dauzan/ShadeShift/foto/Electronic_Prototype.jpg

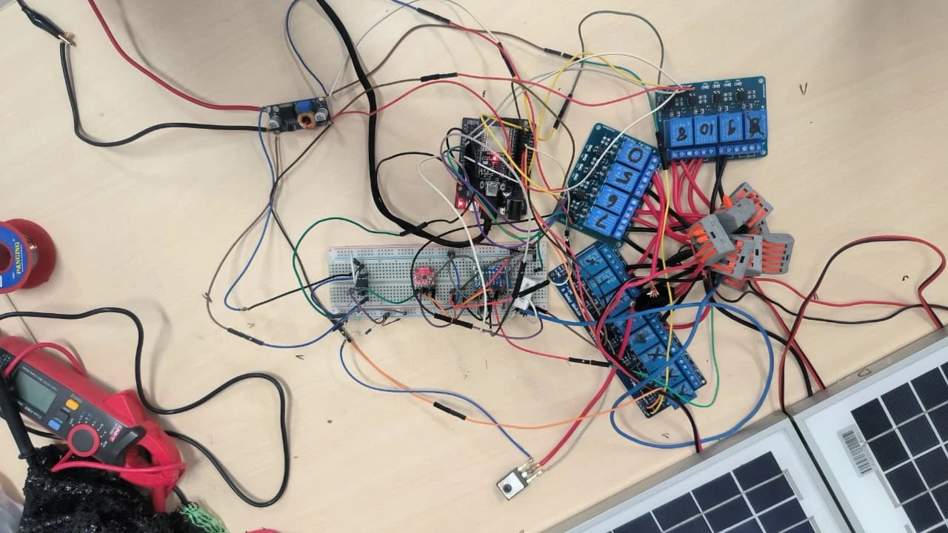
foto/Electronic_Prototype.jpg
