dauzan/ShadeShift/foto/Light_Module_Arrangement.jpg

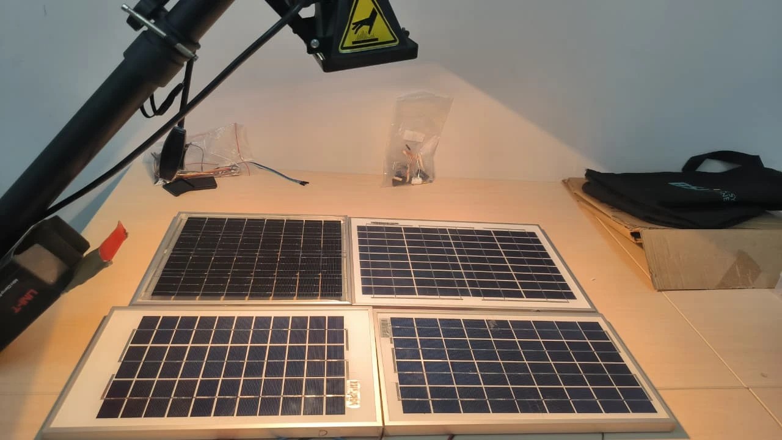
foto/Light_Module_Arrangement.jpg
