dauzan/ShadeShift/rangkaian/1_Relay_Matrix.png

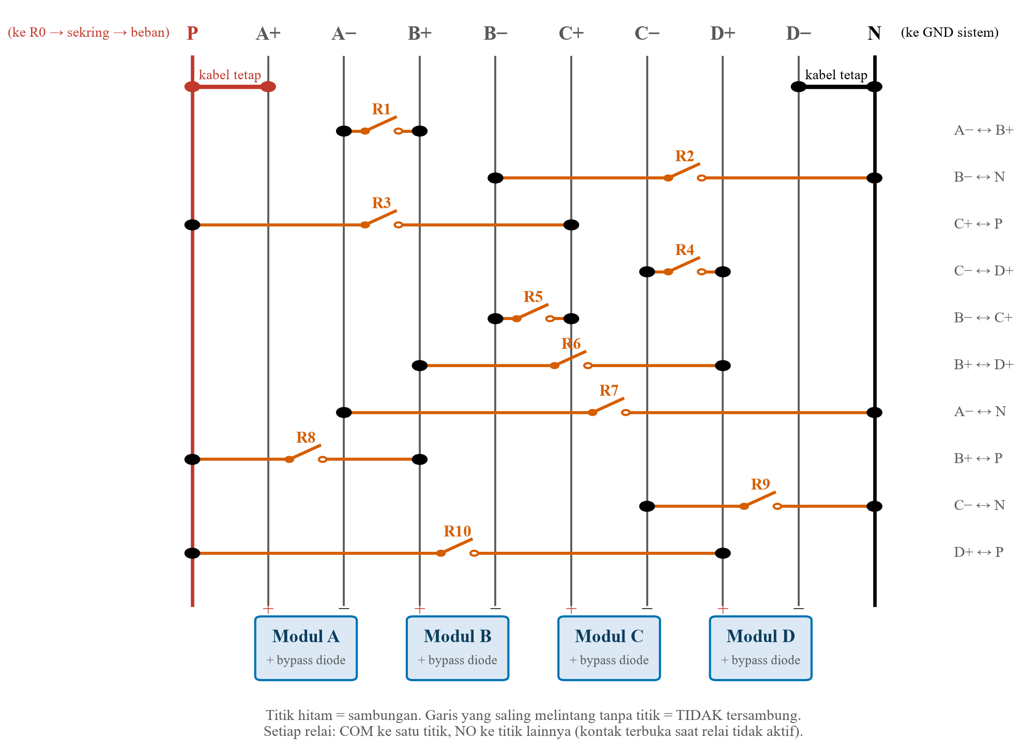
rangkaian/1_Relay_Matrix.png
