dauzan/ShadeShift/rangkaian/Block_Diagram.png

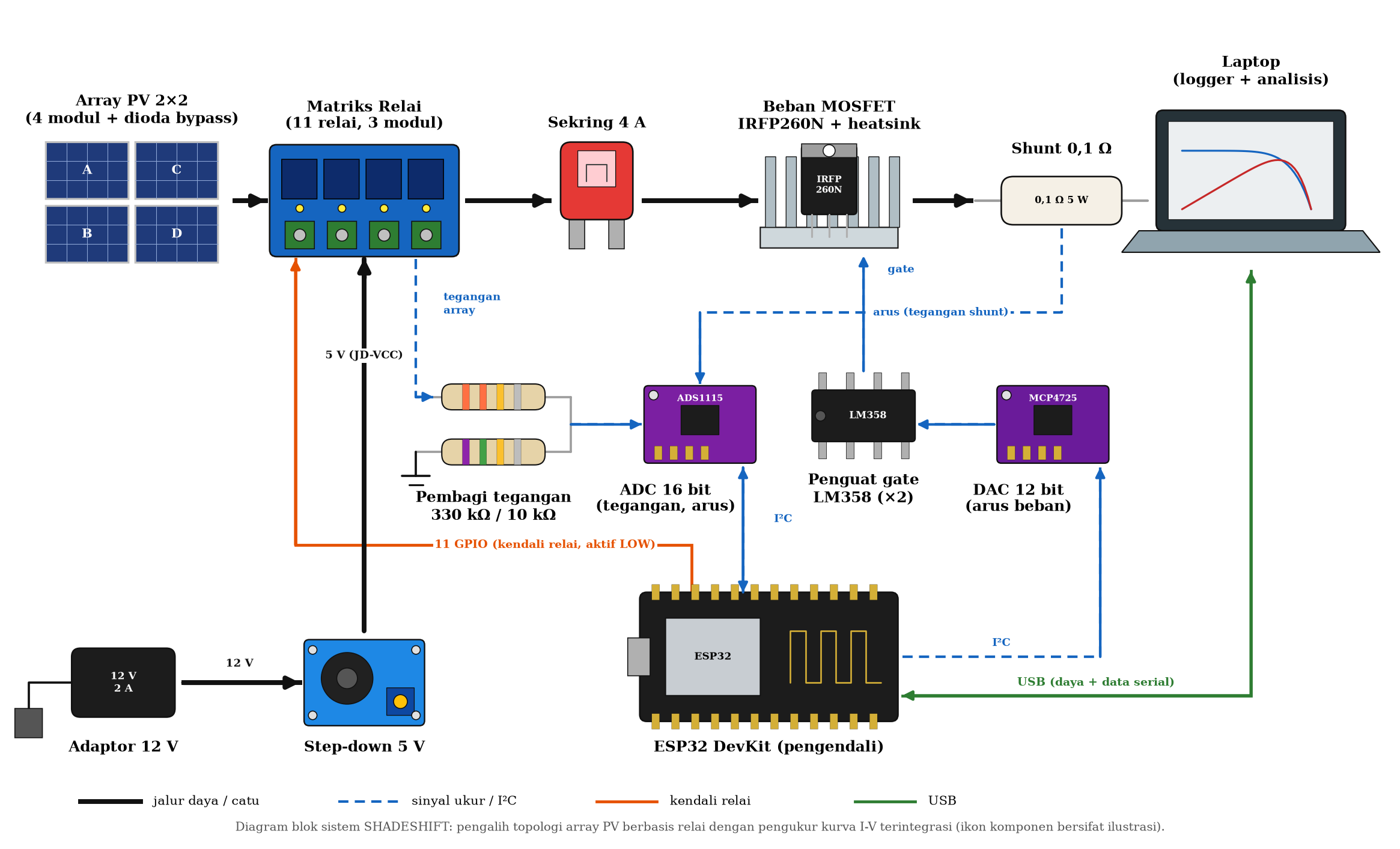
rangkaian/Block_Diagram.png
