dauzan/ShadeShift/rangkaian/L1_Panel_Diode_Wago.png

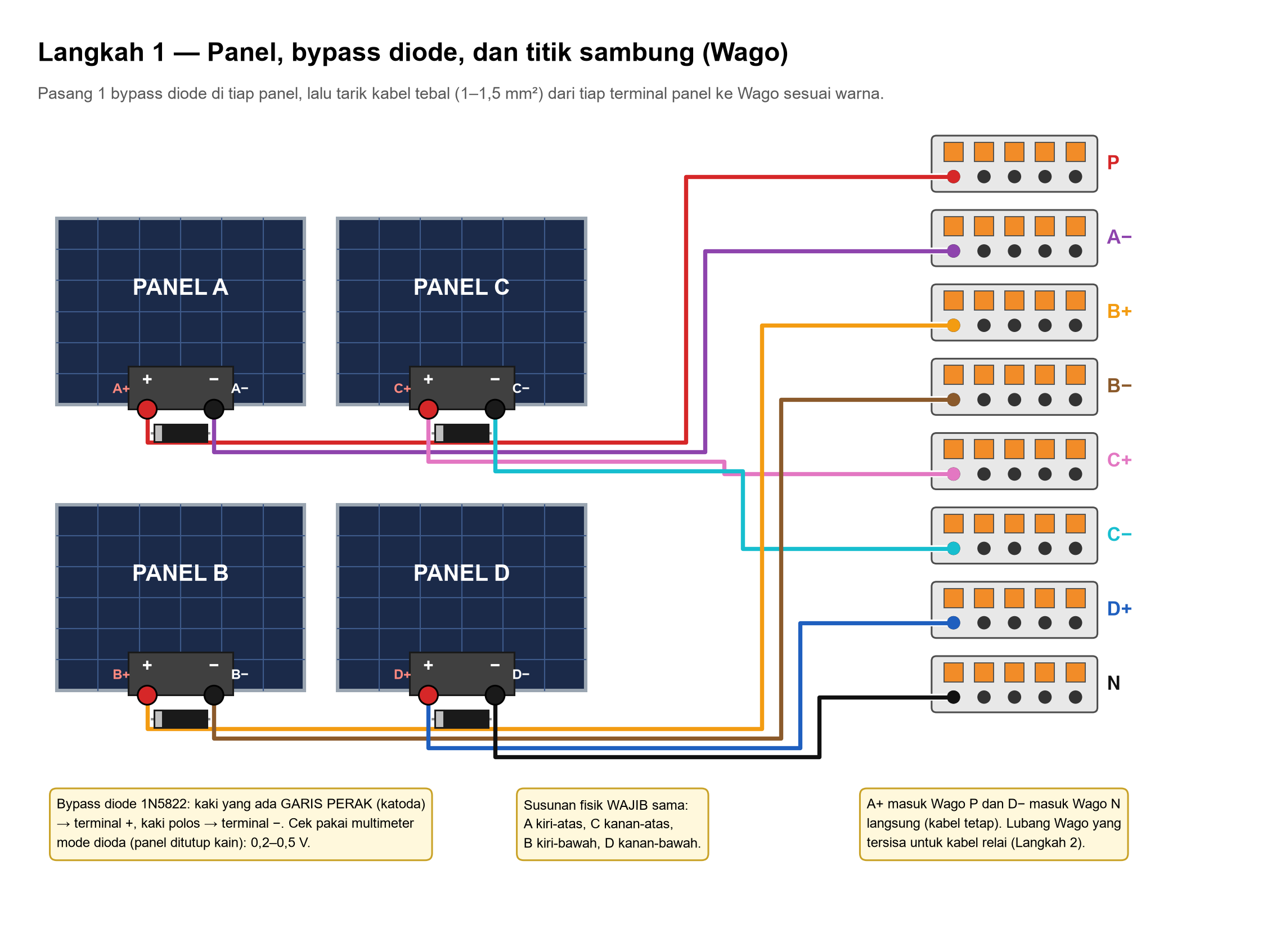
rangkaian/L1_Panel_Diode_Wago.png
