dauzan/ShadeShift/rangkaian/L2_Relay_to_Wago.png

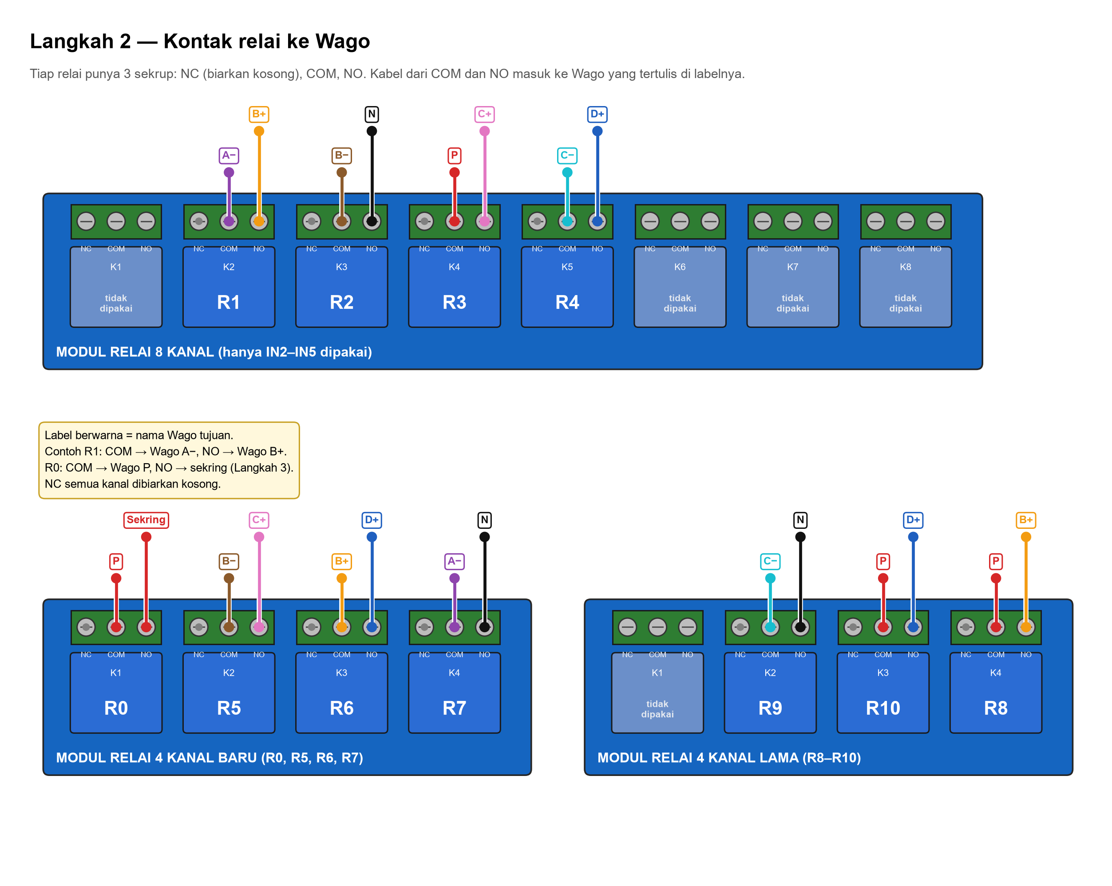
rangkaian/L2_Relay_to_Wago.png
