dauzan/ShadeShift/rangkaian/L3b_Gate_Operator.png

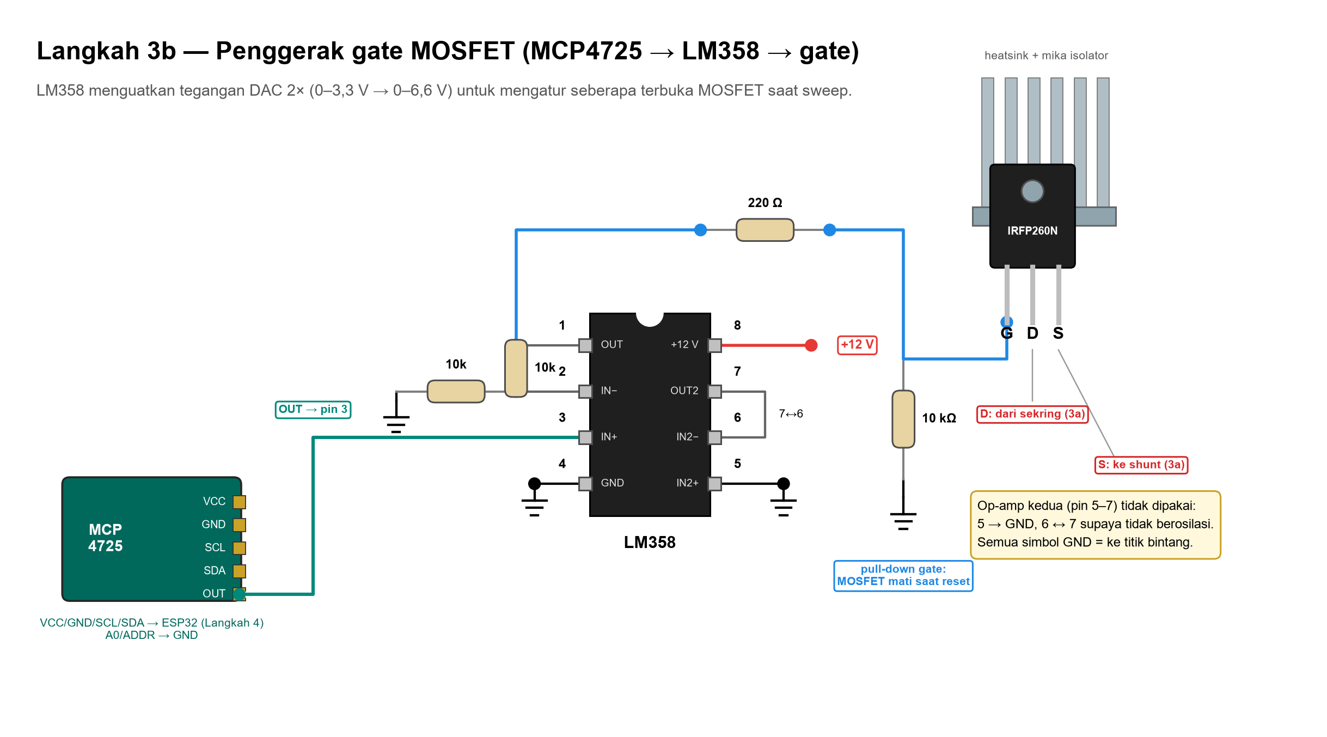
rangkaian/L3b_Gate_Operator.png
