dauzan/ShadeShift/rangkaian/L4a_ESP32_to_Relay.png

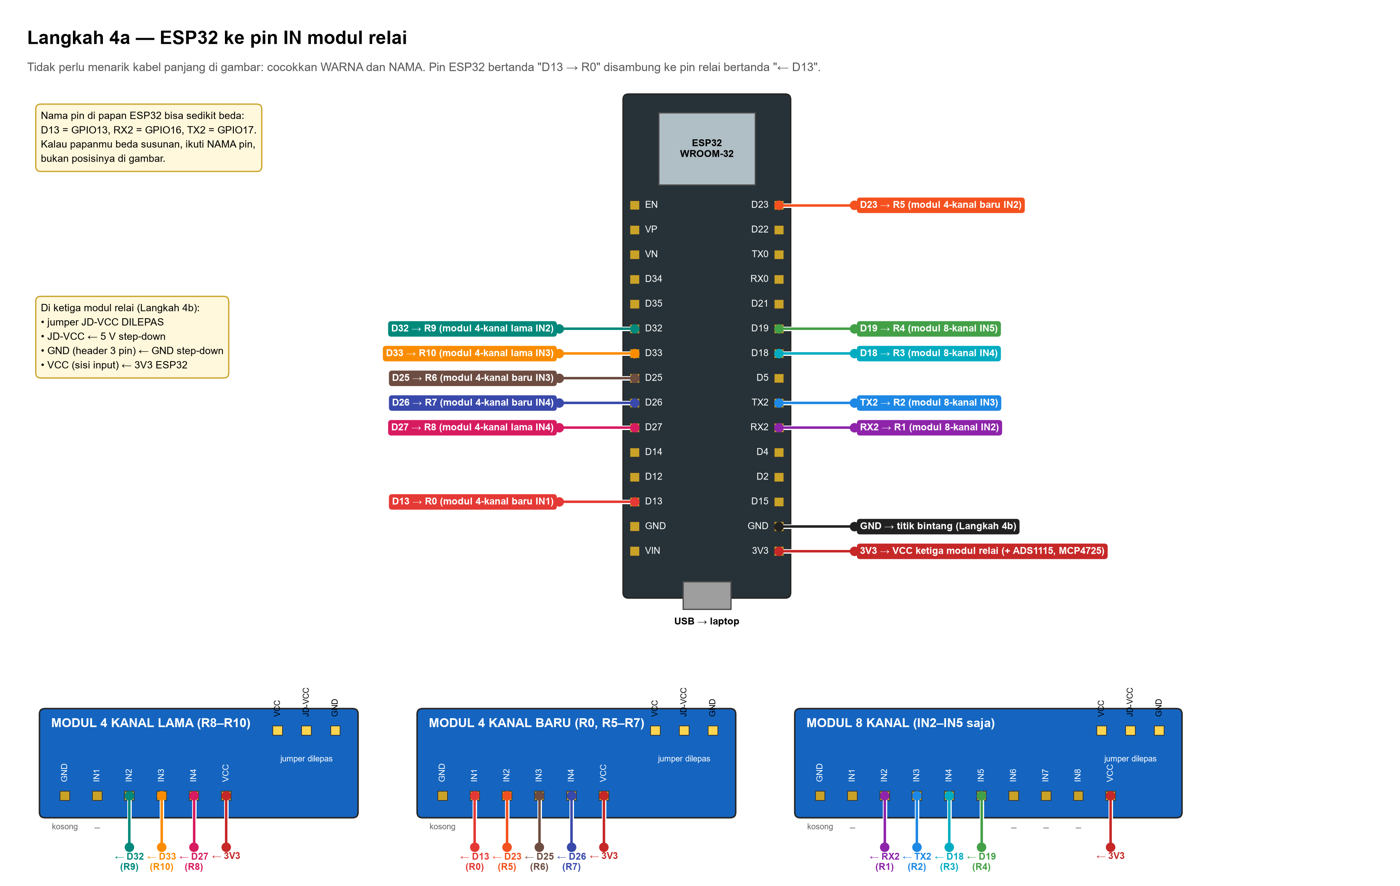
rangkaian/L4a_ESP32_to_Relay.png
