dauzan/ShadeShift/rangkaian/L4b_PowerSupply_I2C_Sensor.png

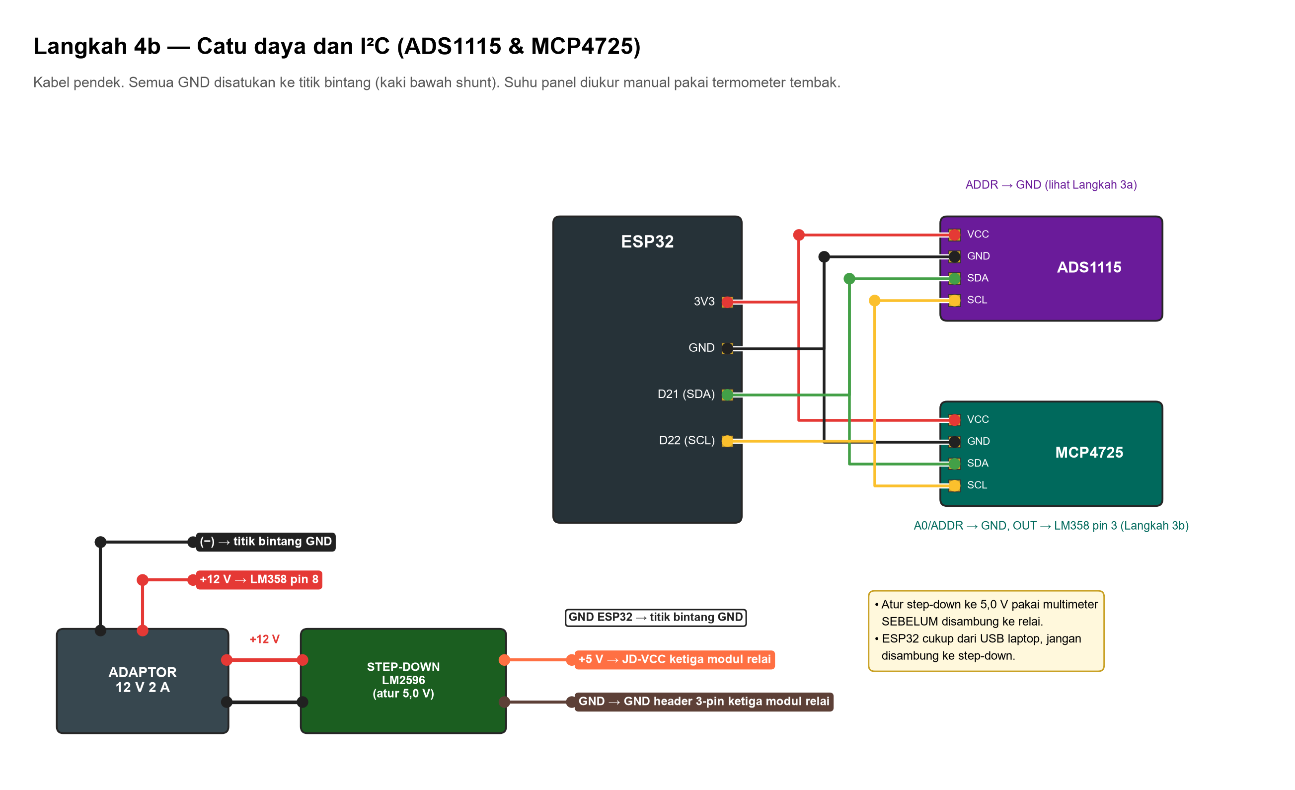
rangkaian/L4b_PowerSupply_I2C_Sensor.png
