dauzan/ShadeShift/rangkaian/L5_Ground_StarShape.png

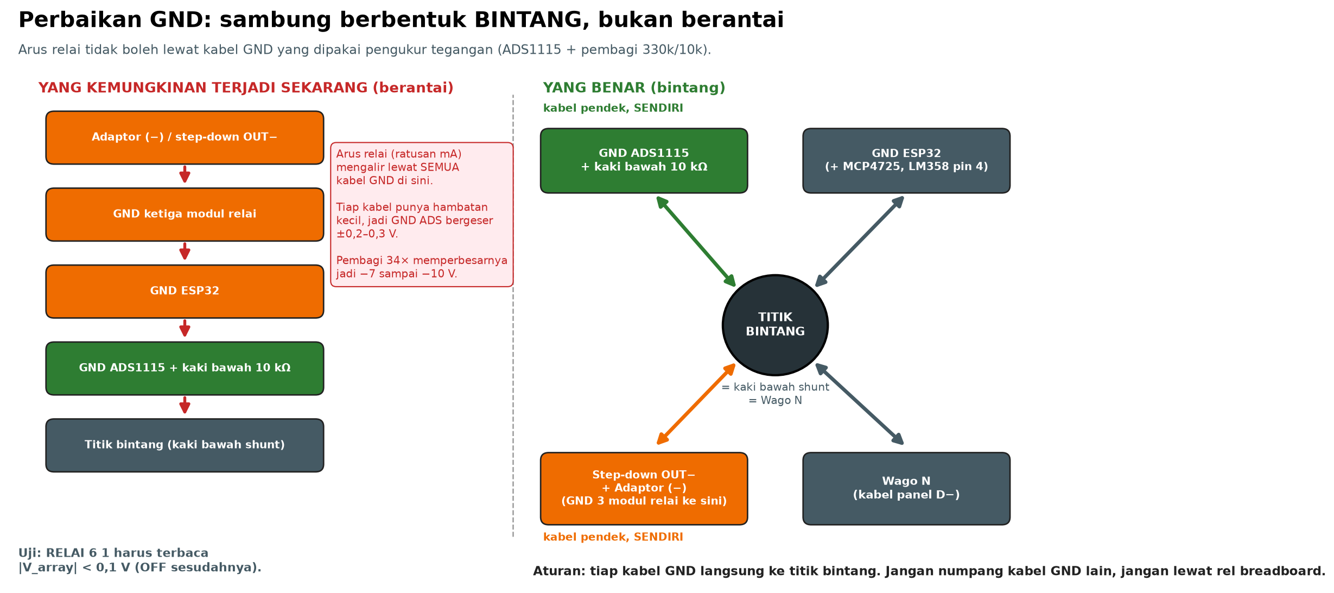
rangkaian/L5_Ground_StarShape.png
