dauzan/ShadeShift/rangkaian/ShadeShift_Scheme.png

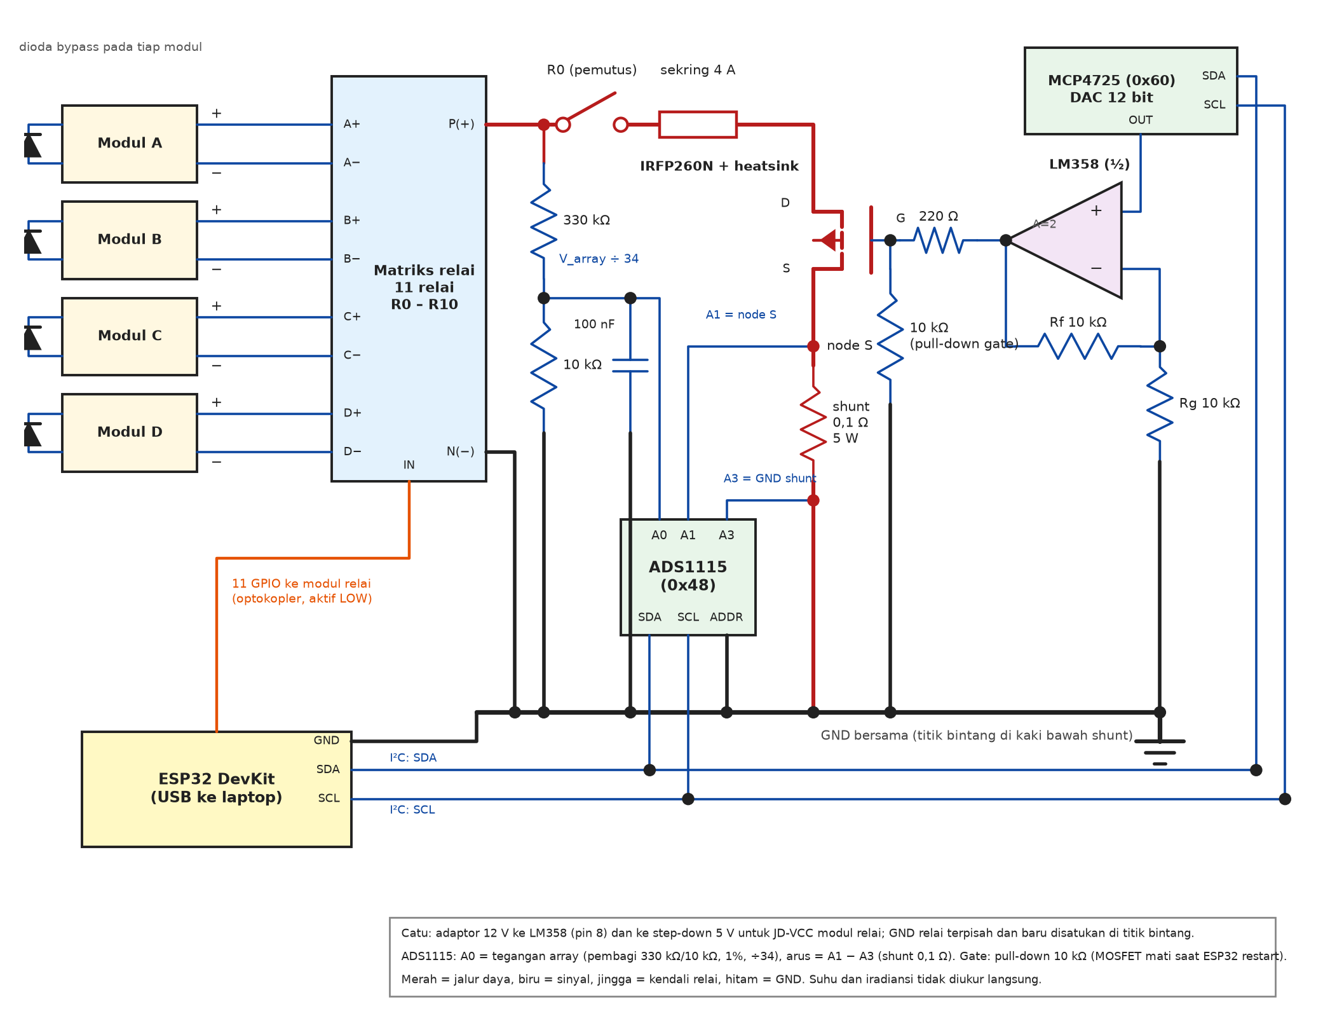
rangkaian/ShadeShift_Scheme.png
