dauzan/ShadeShift/SHADESHIFT_ML/edge_ai/kembaran_lab/kembaran_vs_lab.png

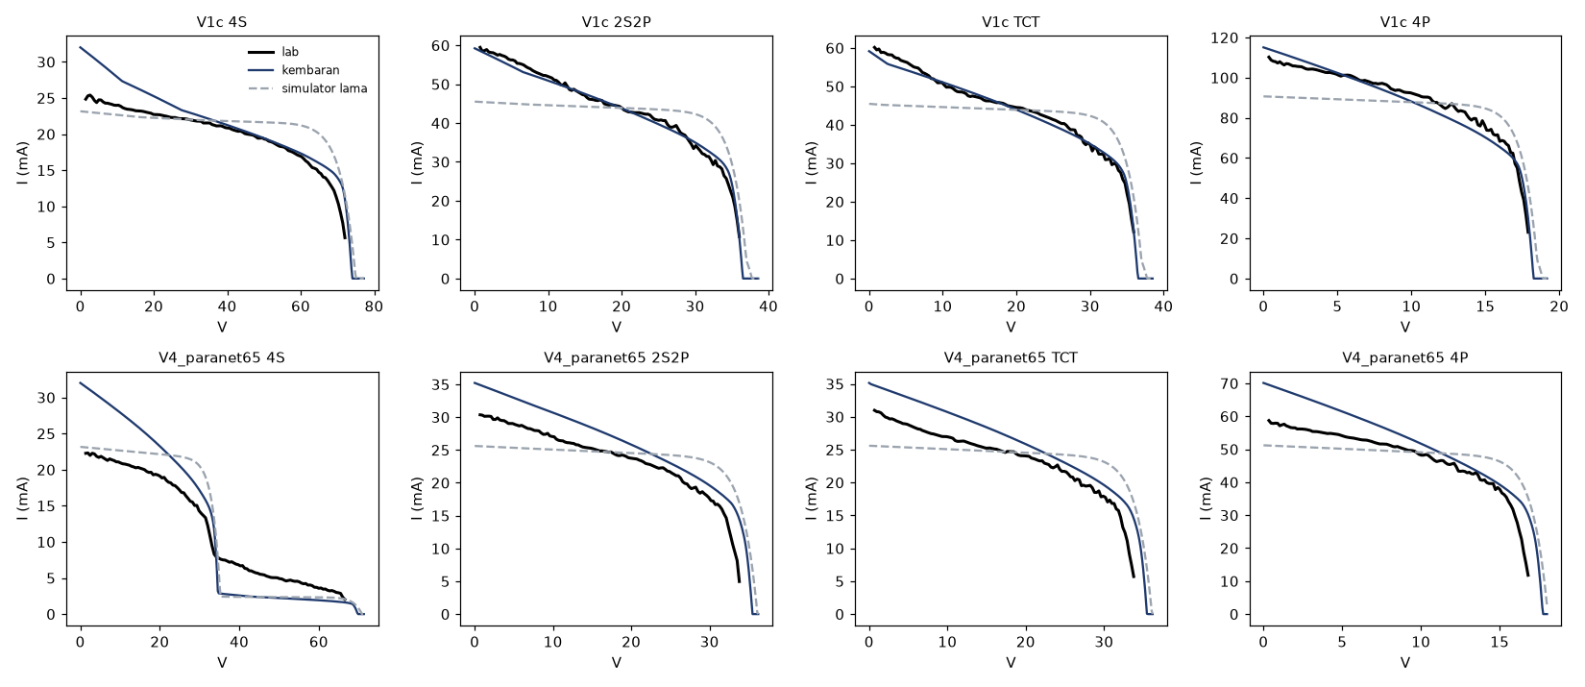
SHADESHIFT_ML/edge_ai/kembaran_lab/kembaran_vs_lab.png
