dauzan/ShadeShift/SHADESHIFT_ML/saklar/1_matriks_saklar_semikonduktor.png

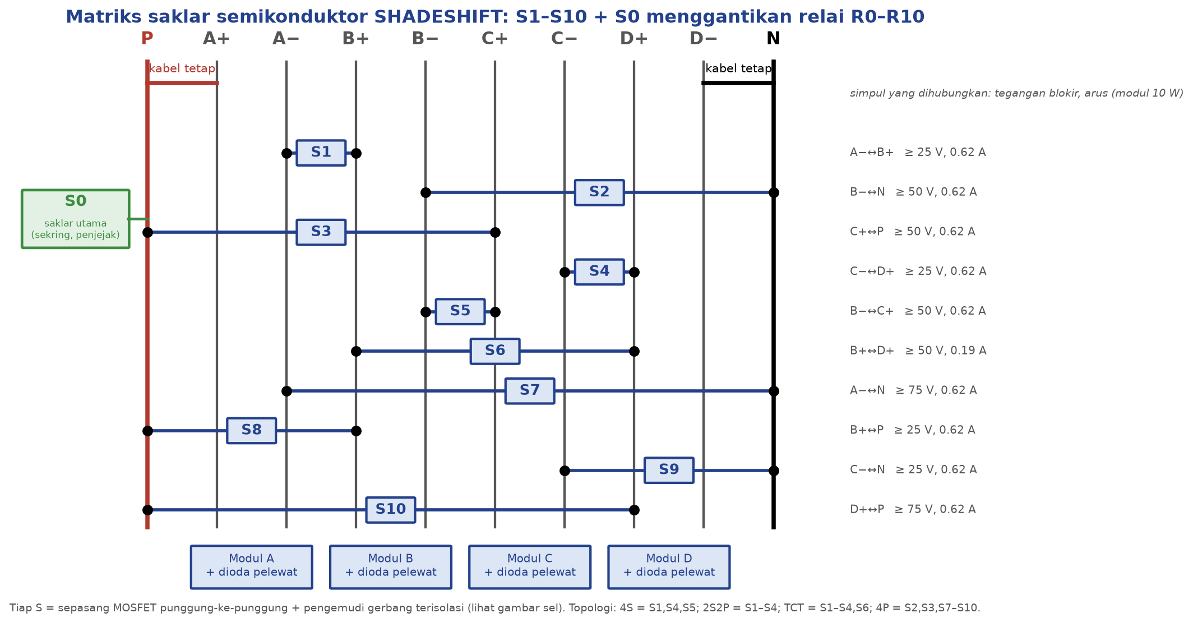
SHADESHIFT_ML/saklar/1_matriks_saklar_semikonduktor.png
