dauzan/ShadeShift/SHADESHIFT_ML/saklar/2_sel_saklar_semikonduktor.png

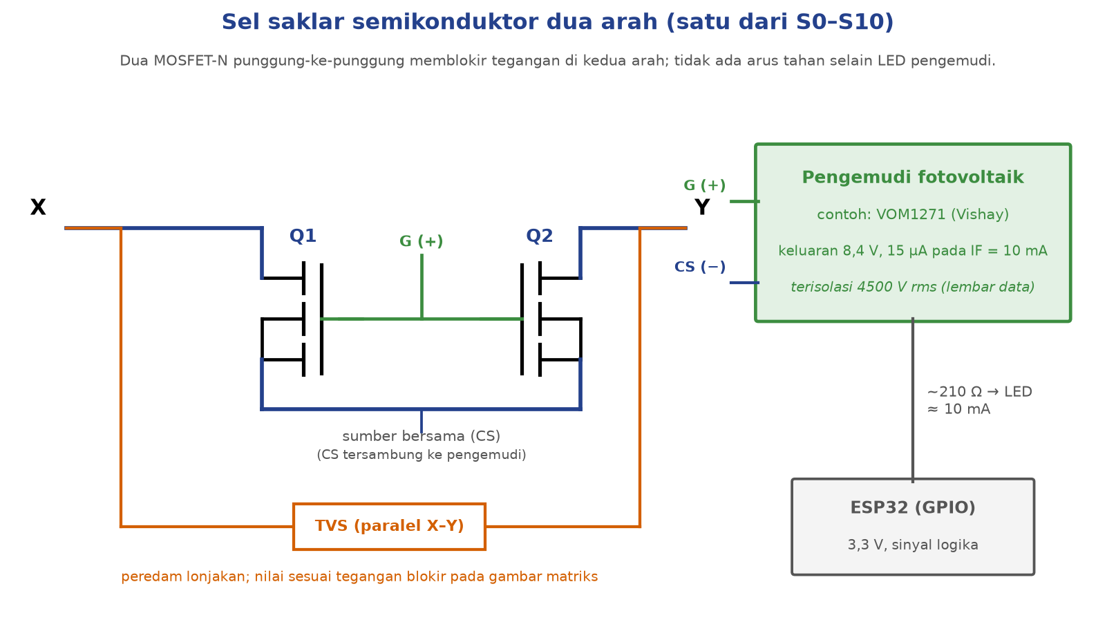
SHADESHIFT_ML/saklar/2_sel_saklar_semikonduktor.png
