dauzan/ShadeShift/SHADESHIFT_ML/saklar/3_perbandingan_relai_semikonduktor.png

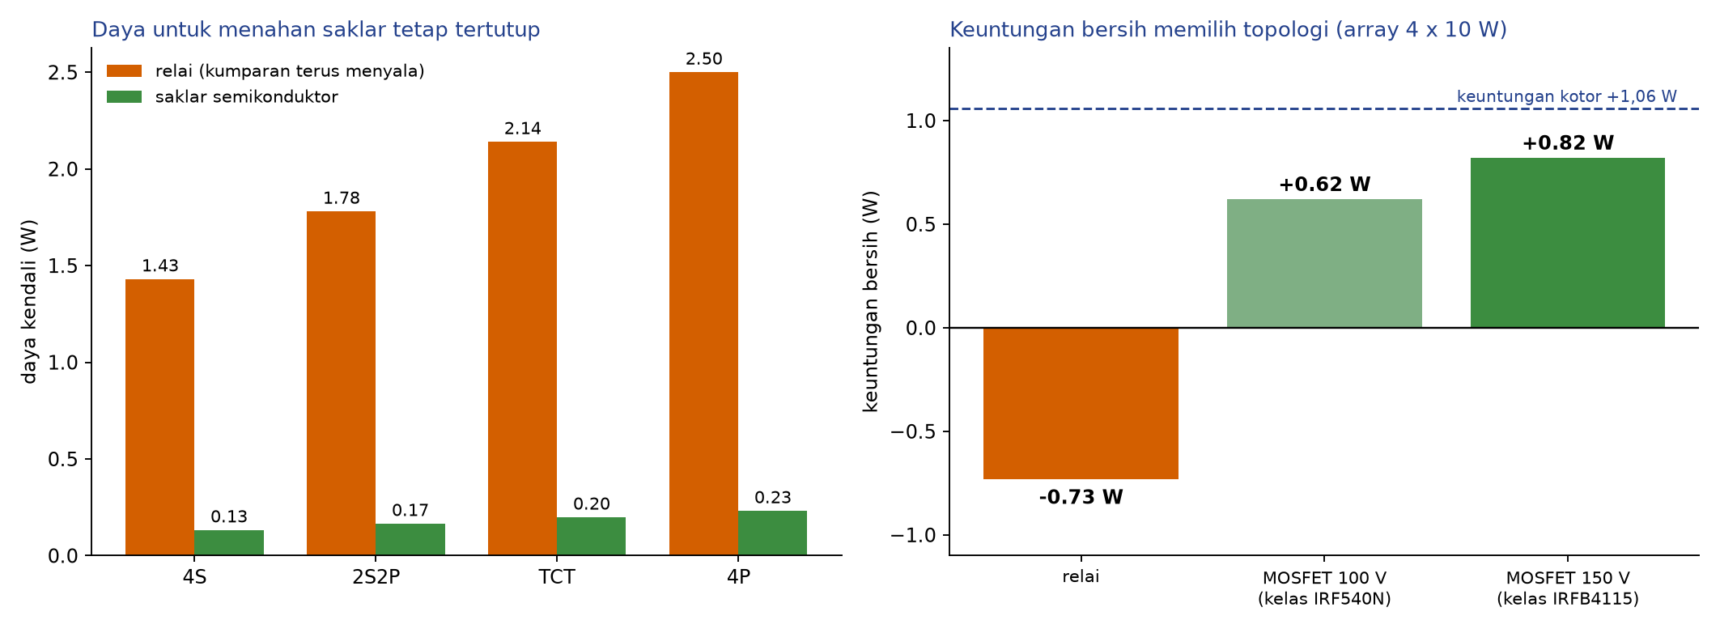
SHADESHIFT_ML/saklar/3_perbandingan_relai_semikonduktor.png
