dauzan/ShadeShift/SHADESHIFT_ML/uji_model/hasil/grafik_pemilihan_fisik.png

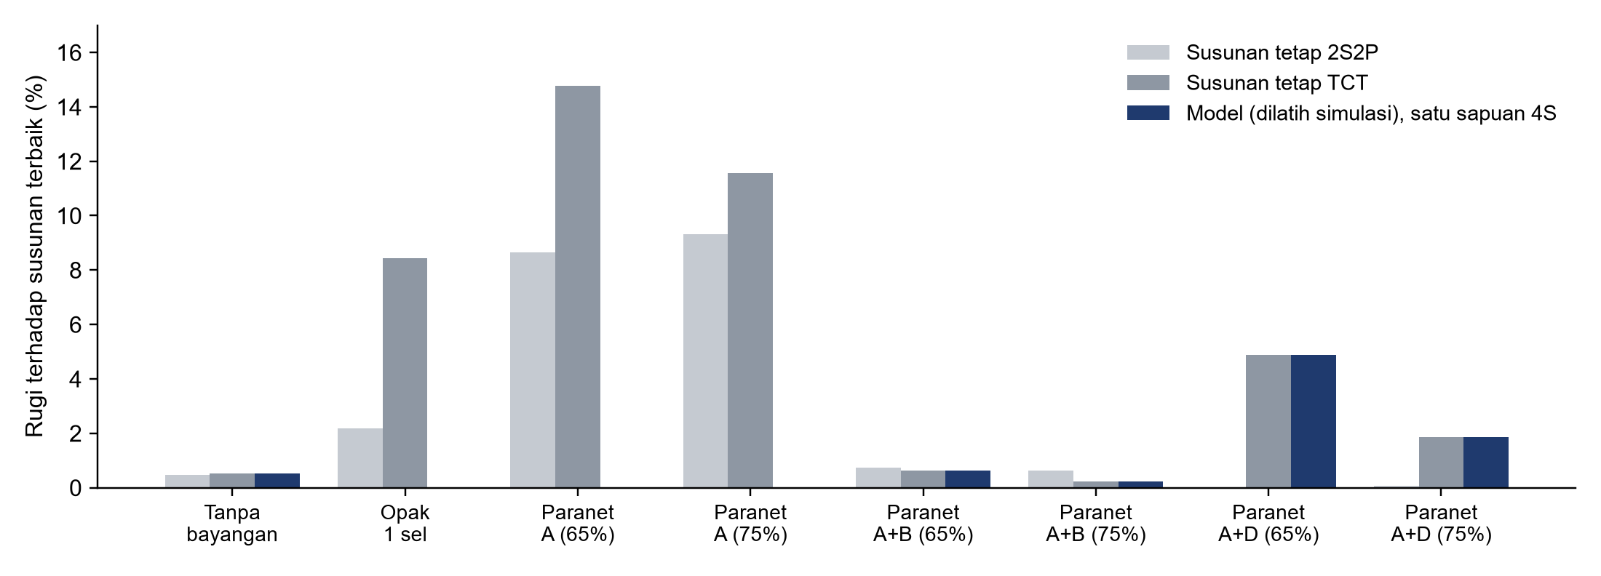
SHADESHIFT_ML/uji_model/hasil/grafik_pemilihan_fisik.png
