dauzan/ShadeShift/rangkaian/2_Measurement_Control_Circuit.png

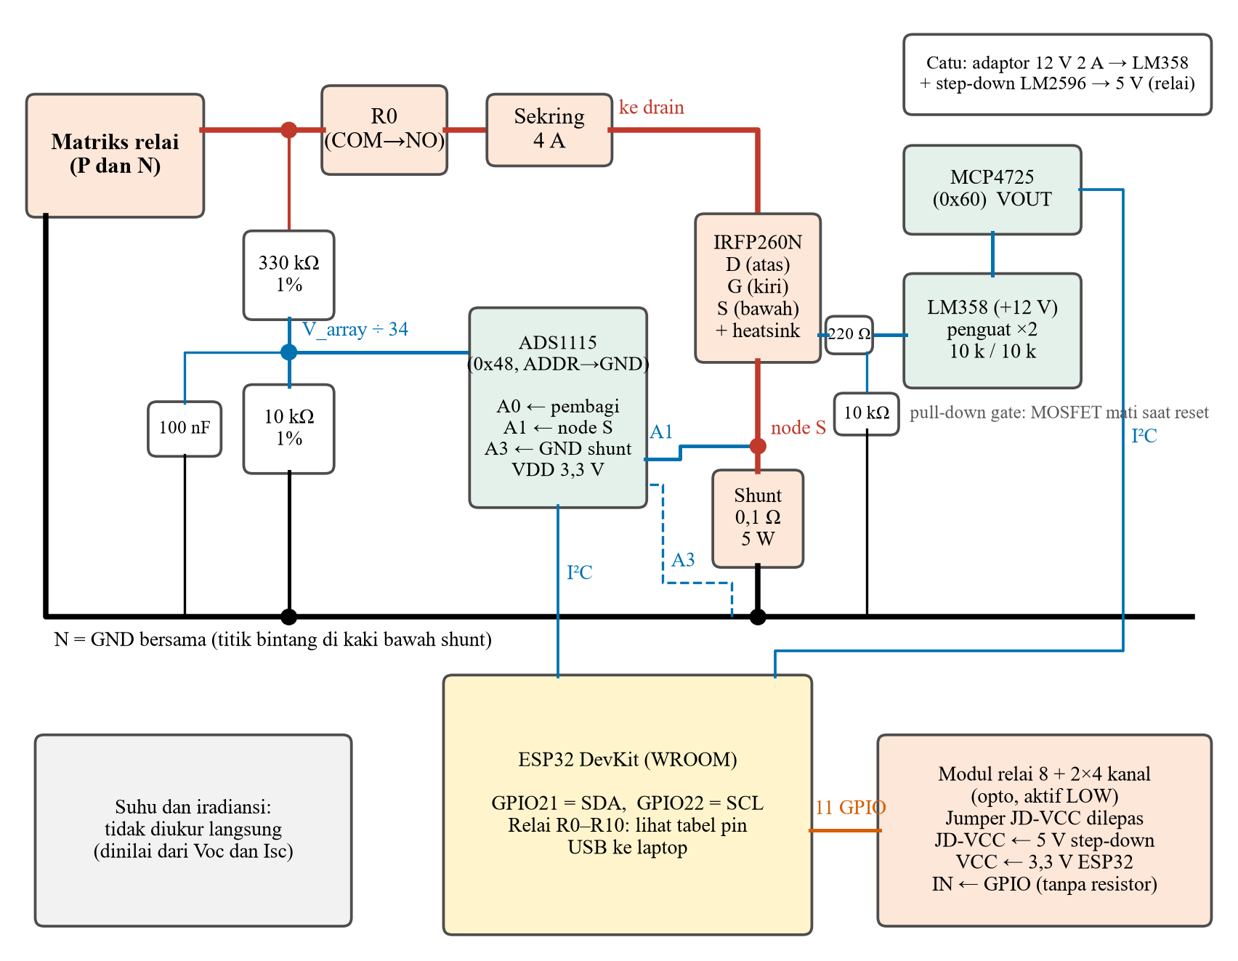
rangkaian/2_Measurement_Control_Circuit.png
