dauzan/ShadeShift/rangkaian/L3a_Measurement_Power_Path.png

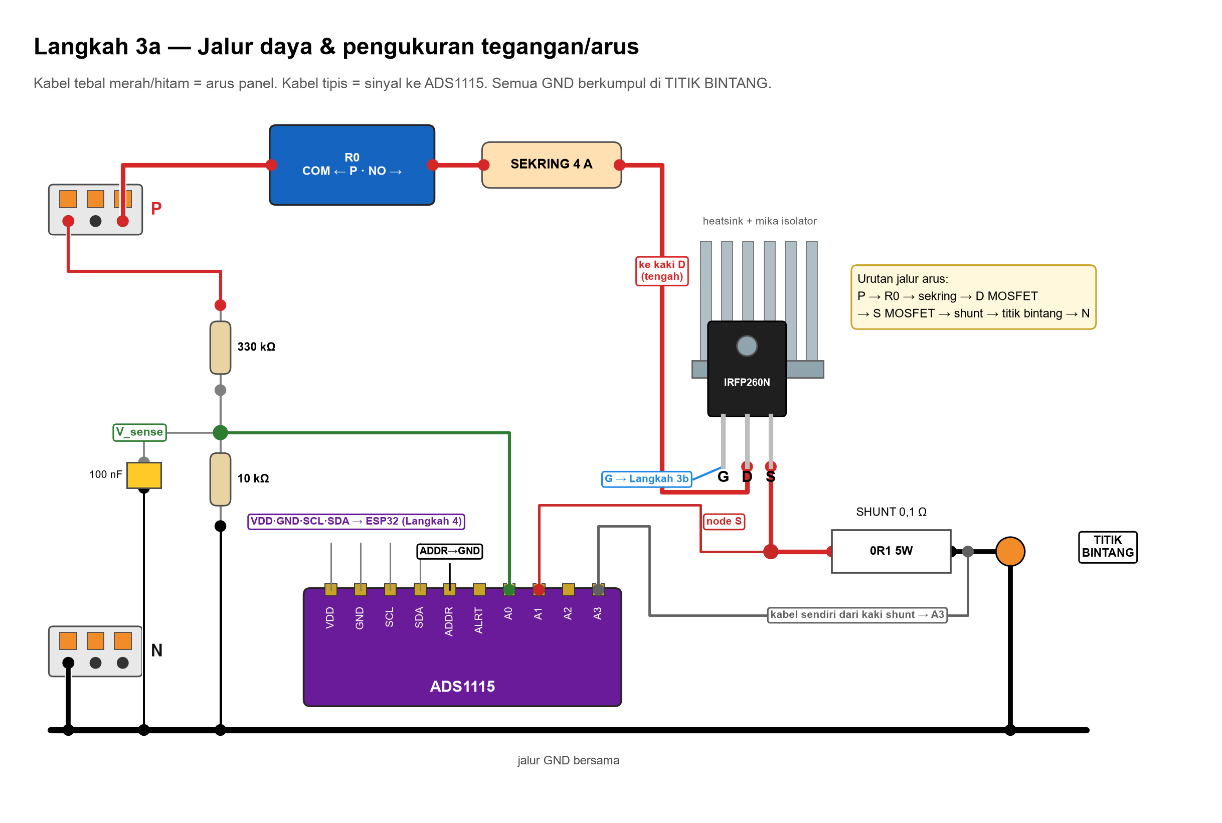
rangkaian/L3a_Measurement_Power_Path.png
