dauzan/ShadeShift/SHADESHIFT_ML/edge_ai/pemilih/uji_pemilih/data_uji.h

// Kurva uji (lab, sapuan 4S, mentah dari berkas CSV) + fitur dan keputusan harapan. Dibuat otomatis oleh latih_ekspor.py.
#pragma once
#define N_UJI 12
#define N_MAKS_TITIK 202
static const char* UJI_NAMA[N_UJI] = {"V1c_4S_u1", "V1_4S_u1", "V3_opak_4S_u1", "V3_paranet65_4S_u1", "V3_paranet75_4S_u2", "V4_paranet65_4S_u1", "V4_paranet75_4S_u3", "V6_paranet65_4S_u1", "V6_paranet75_4S_u2", "V1b_4S_u2", "V3_opak_4S_u3", "V6_paranet65_4S_u3"};
static const uint16_t UJI_N[N_UJI] = {202, 202, 202, 202, 202, 202, 202, 202, 202, 202, 202, 202};
static const float UJI_V[N_UJI][N_MAKS_TITIK] = {
  {73.552597f, 73.1636963f, 73.1467972f, 73.1340027f, 73.1340027f, 73.1128006f, 73.1212997f, 73.0958023f, 73.1128006f, 73.0596008f, 73.0979004f, 73.0341034f, 73.0765991f, 73.0085983f, 73.0596008f, 72.9746017f, 73.0383987f, 72.9533997f, 73.0129013f, 72.9279022f, 72.9980011f, 72.893898f, 72.9682007f, 72.8619995f, 72.9300003f, 72.8365021f, 72.9215012f, 72.7939987f, 72.9023972f, 72.7578964f, 72.8768997f, 72.7110977f, 72.8429031f, 72.6750031f, 72.8216019f, 72.6473999f, 72.7770004f, 72.6219025f, 72.7429962f, 72.5580978f, 72.6984024f, 72.5093002f, 72.6601028f, 72.4561005f, 72.6324997f, 72.411499f, 72.5751038f, 72.3583984f, 72.5475006f, 72.3095016f, 72.5028992f, 72.254303f, 72.4391022f, 72.1989975f, 72.3902969f, 72.1288986f, 72.332901f, 72.0672989f, 72.2669983f, 71.9865036f, 72.2309036f, 71.9121017f, 72.1565018f, 71.844101f, 72.088501f, 71.7548981f, 72.0077972f, 71.6570969f, 71.9248962f, 71.6018982f, 71.831398f, 71.4978027f, 71.7570038f, 71.3872986f, 71.6656036f, 71.2916031f, 71.5530014f, 71.1747971f, 71.4934998f, 71.0514984f, 71.3744965f, 70.9069977f, 71.2427979f, 70.7944031f, 71.1407013f, 70.6710968f, 70.9962997f, 70.5202026f, 70.8623962f, 70.3843002f, 70.6648026f, 70.1802979f, 70.4969025f, 69.9869003f, 70.3714981f, 69.7574005f, 70.1355972f, 69.5109024f, 69.7594986f, 69.1708984f, 69.385498f, 68.7331009f, 68.7990036f, 68.4377975f, 68.2125015f, 67.7152023f, 67.2753983f, 66.8651962f, 66.3339996f, 65.8919983f, 65.6688995f, 64.7254028f, 64.6552963f, 63.4715996f, 63.5714989f, 62.1030998f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
9998f, 0.0247699991f, 0.0258600004f, 0.0250000004f, 0.0257799998f},
  {0.0f, 0.00164000003f, 0.00164000003f, 0.00179999997f, 0.00171999994f, 0.00164000003f, 0.00156f, 0.00164000003f, 0.00171999994f, 0.00156f, 0.00171999994f, 0.00179999997f, 0.00179999997f, 0.00187000004f, 0.00194999995f, 0.00179999997f, 0.00203000009f, 0.00203000009f, 0.00203000009f, 0.00227000006f, 0.00211f, 0.00227000006f, 0.00233999989f, 0.00242000003f, 0.00233999989f, 0.00233999989f, 0.00242000003f, 0.00242000003f, 0.00242000003f, 0.00273000007f, 0.00266f, 0.00266f, 0.00249999994f, 0.00266f, 0.00288999989f, 0.00273000007f, 0.00288999989f, 0.00288999989f, 0.00313000008f, 0.00297000003f, 0.00313000008f, 0.00319999992f, 0.00304999994f, 0.00335999997f, 0.00328000006f, 0.00343999988f, 0.00343999988f, 0.00352000003f, 0.00359000009f, 0.00367000001f, 0.00367000001f, 0.00390999997f, 0.00383000006f, 0.00406000018f, 0.00406000018f, 0.00430000015f, 0.00413999986f, 0.00430000015f, 0.00406000018f, 0.00422f, 0.00444999989f, 0.00453000003f, 0.00461000018f, 0.00461000018f, 0.00484000007f, 0.00477f, 0.00477f, 0.00499999989f, 0.00499999989f, 0.00522999978f, 0.00530999992f, 0.00554999989f, 0.00530999992f, 0.0057000001f, 0.00561999995f, 0.00577999977f, 0.00585999992f, 0.0060200002f, 0.00608999981f, 0.00608999981f, 0.00640999991f, 0.00640999991f, 0.0066399998f, 0.00640999991f, 0.00694999984f, 0.00680000009f, 0.00680000009f, 0.00726999994f, 0.00726999994f, 0.00757999998f, 0.00766000012f, 0.00773000019f, 0.00780999986f, 0.00780999986f, 0.0080500003f, 0.00812000036f, 0.00820000004f, 0.00836000033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
0243800003f, 0.0260199998f, 0.0242999997f, 0.0261700004f, 0.0242199991f},
  {0.0f, 0.00187000004f, 0.00211f, 0.00218999991f, 0.00218999991f, 0.00218999991f, 0.00227000006f, 0.00194999995f, 0.00233999989f, 0.00249999994f, 0.00242000003f, 0.00266f, 0.00242000003f, 0.00233999989f, 0.00266f, 0.00249999994f, 0.00273000007f, 0.00297000003f, 0.00280999998f, 0.00297000003f, 0.00288999989f, 0.00297000003f, 0.00304999994f, 0.00297000003f, 0.00328000006f, 0.00313000008f, 0.00335999997f, 0.00335999997f, 0.00335999997f, 0.00374999992f, 0.00352000003f, 0.00367000001f, 0.00374999992f, 0.00374999992f, 0.00390999997f, 0.00374999992f, 0.00398000004f, 0.00390999997f, 0.00413999986f, 0.00430000015f, 0.00437999982f, 0.00444999989f, 0.00437999982f, 0.00461000018f, 0.00453000003f, 0.00477f, 0.00461000018f, 0.00484000007f, 0.00492000021f, 0.00499999989f, 0.00499999989f, 0.00530999992f, 0.00516000018f, 0.00530999992f, 0.00539000006f, 0.00530999992f, 0.0057000001f, 0.00561999995f, 0.00577999977f, 0.00608999981f, 0.0060200002f, 0.00640999991f, 0.00632999977f, 0.00656000013f, 0.00656000013f, 0.00702999998f, 0.00680000009f, 0.00702999998f, 0.00694999984f, 0.0071899998f, 0.00742000015f, 0.00757999998f, 0.00773000019f, 0.00773000019f, 0.0080500003f, 0.00820000004f, 0.00836000033f, 0.00851999968f, 0.00851999968f, 0.00851999968f, 0.00875000004f, 0.00913999975f, 0.00930000003f, 0.00937999971f, 0.00953000039f, 0.00968999974f, 0.00999999978f, 0.0099200001f, 0.0103099998f, 0.0102300001f, 0.0107000005f, 0.0108599998f, 0.0110200001f, 0.0113300001f, 0.0113300001f, 0.0117199998f, 0.0118000004f, 0.0119500002f, 0.0122699998f, 0.0125799999f, 0.0128899999f, 0.0131999999f, 0.0133600002f, 0.0135899996f, 0.0139100002f, 0.0141399996f, 0.0144499997f, 0.01461f, 0.0149999997f, 0.0149999997f, 0.0153900003f, 0.0156199997f, 0.01609f, 0.0162499994f, 0.0164800007f, 0.0165599994f, 0.01719f, 0.0174199995f, 0.0176599994f, 0.0178900007f, 0.0183600001f, 0.0183600001f, 0.0189100001f, 0.0188299995f, 0.0195300002f, 0.0198400002f, 0.0200800002f, 0.0199999996f, 0.0203900002f, 0.0203099996f, 0.0207000002f, 0.0206199996f, 0.0210900009f, 0.0213300008f, 0.0217199996f, 0.0212500002f, 0.0220299996f, 0.0214799996f, 0.0224200003f, 0.0220299996f, 0.0228100009f, 0.0221100003f, 0.0231299996f, 0.0223399997f, 0.0232800003f, 0.0228899997f, 0.0235200003f, 0.0229700003f, 0.0238300003f, 0.0231299996f, 0.0241400003f, 0.0233600009f, 0.0242199991f, 0.0236699991f, 0.0245299991f, 0.0239100009f, 0.0247699991f, 0.0239100009f, 0.0249199998f, 0.0241400003f, 0.0249199998f, 0.0242999997f, 0.0251599997f, 0.0242199991f, 0.0251599997f, 0.0242199991f, 0.0251599997f, 0.0240599997f, 0.0252299998f, 0.0243800003f, 0.0253100004f, 0.0241400003f, 0.0253100004f, 0.0242999997f, 0.0252299998f, 0.0242999997f, 0.0252299998f, 0.0240599997f, 0.0253899992f, 0.0243800003f, 0.0251599997f, 0.0240599997f, 0.0254699998f, 0.0242199991f, 0.0253899992f, 0.0241400003f, 0.0254699998f, 0.0240599997f, 0.0253899992f, 0.0240599997f, 0.0253100004f, 0.0242199991f, 0.0253899992f, 0.0242199991f, 0.0253899992f, 0.0240599997f, 0.0255500004f, 0.0241400003f, 0.0255500004f, 0.0239799991f, 0.0254699998f, 0.0239799991f},
  {0.0f, 0.00141000003f, 0.00156f, 0.00156f, 0.00147999998f, 0.00164000003f, 0.00164000003f, 0.00164000003f, 0.00171999994f, 0.00164000003f, 0.00179999997f, 0.00179999997f, 0.00194999995f, 0.00187000004f, 0.00194999995f, 0.00194999995f, 0.00211f, 0.00203000009f, 0.00211f, 0.00203000009f, 0.00242000003f, 0.00233999989f, 0.00233999989f, 0.00242000003f, 0.00249999994f, 0.00233999989f, 0.00233999989f, 0.00242000003f, 0.00273000007f, 0.00266f, 0.00273000007f, 0.00280999998f, 0.00288999989f, 0.00280999998f, 0.00304999994f, 0.00304999994f, 0.00313000008f, 0.00304999994f, 0.00328000006f, 0.00313000008f, 0.00352000003f, 0.00359000009f, 0.00335999997f, 0.00343999988f, 0.00343999988f, 0.00383000006f, 0.00383000006f, 0.00398000004f, 0.00413999986f, 0.00398000004f, 0.00413999986f, 0.00430000015f, 0.00437999982f, 0.00444999989f, 0.00437999982f, 0.00484000007f, 0.00484000007f, 0.00461000018f, 0.00492000021f, 0.00499999989f, 0.00508000003f, 0.00516000018f, 0.00530999992f, 0.00530999992f, 0.00530999992f, 0.00554999989f, 0.00547000021f, 0.00585999992f, 0.00577999977f, 0.00594000006f, 0.00608999981f, 0.00625000009f, 0.00640999991f, 0.0066399998f, 0.00656000013f, 0.00680000009f, 0.00694999984f, 0.00711000012f, 0.00734000001f, 0.00726999994f, 0.00766000012f, 0.00766000012f, 0.00773000019f, 0.0080500003f, 0.00812000036f, 0.00844000001f, 0.00844000001f, 0.00875000004f, 0.00875000004f, 0.00891000032f, 0.00922000036f, 0.00953000039f, 0.00977000035f, 0.0099200001f, 0.00999999978f, 0.0103099998f, 0.0105499998f, 0.0107000005f, 0.0110200001f, 0.0110900002f, 0.0114099998f, 0.0117199998f, 0.0117199998f, 0.0122699998f, 0.0122699998f, 0.0125799999f, 0.0126599995f, 0.0130500002f, 0.0132799996f, 0.0134399999f, 0.0138299996f, 0.0141399996f, 0.0144499997f, 0.0147700002f, 0.01492f, 0.0153099997f, 0.01578f, 0.0158600006f, 0.0162499994f, 0.0164800007f, 0.0167999994f, 0.0173400007f, 0.0170300007f, 0.0180500001f, 0.0182799995f, 0.0182000007f, 0.0185899995f, 0.0192200001f, 0.0193000007f, 0.0198400002f, 0.0194499996f, 0.0204700008f, 0.0202300008f, 0.0208599996f, 0.0206199996f, 0.0216400009f, 0.0213300008f, 0.0221100003f, 0.0215600003f, 0.0225000009f, 0.0218800008f, 0.0231999997f, 0.0225799996f, 0.0235900003f, 0.0229700003f, 0.0240599997f, 0.0232800003f, 0.0246099997f, 0.0236699991f, 0.0249199998f, 0.0238300003f, 0.0253899992f, 0.0241400003f, 0.0254699998f, 0.0242999997f, 0.0257799998f, 0.0247699991f, 0.0262499992f, 0.0248399992f, 0.0263299998f, 0.0250000004f, 0.0266399998f, 0.0250799991f, 0.0266399998f, 0.0254699998f, 0.0267200004f, 0.0252299998f, 0.0269499999f, 0.0252299998f, 0.0270300005f, 0.0253899992f, 0.0271099992f, 0.0252299998f, 0.0271099992f, 0.0253100004f, 0.0269499999f, 0.0254699998f, 0.0269499999f, 0.0254699998f, 0.0270300005f, 0.0253100004f, 0.0270300005f, 0.0253899992f, 0.0269499999f, 0.0254699998f, 0.0269499999f, 0.0253899992f, 0.0269499999f, 0.0254699998f, 0.0270300005f, 0.0256999992f, 0.0268799998f, 0.0254699998f, 0.0271899998f, 0.0256999992f, 0.0271099992f, 0.0255500004f, 0.0270300005f, 0.0253100004f, 0.0271899998f, 0.0254699998f, 0.0269499999f},
  {0.0f, 0.00179999997f, 0.00187000004f, 0.00187000004f, 0.00203000009f, 0.00194999995f, 0.00194999995f, 0.00203000009f, 0.00218999991f, 0.00211f, 0.00218999991f, 0.00211f, 0.00218999991f, 0.00233999989f, 0.00233999989f, 0.00242000003f, 0.00242000003f, 0.00227000006f, 0.00233999989f, 0.00242000003f, 0.00258000009f, 0.00266f, 0.00273000007f, 0.00266f, 0.00273000007f, 0.00273000007f, 0.00297000003f, 0.00297000003f, 0.00313000008f, 0.00304999994f, 0.00313000008f, 0.00304999994f, 0.00304999994f, 0.00304999994f, 0.00328000006f, 0.00343999988f, 0.00343999988f, 0.00335999997f, 0.00352000003f, 0.00343999988f, 0.00367000001f, 0.00390999997f, 0.00390999997f, 0.00367000001f, 0.00398000004f, 0.00398000004f, 0.00406000018f, 0.00398000004f, 0.00413999986f, 0.00430000015f, 0.00437999982f, 0.00422f, 0.00453000003f, 0.00453000003f, 0.00461000018f, 0.00468999986f, 0.00461000018f, 0.00477f, 0.00468999986f, 0.00484000007f, 0.00499999989f, 0.00499999989f, 0.00516000018f, 0.00499999989f, 0.00516000018f, 0.00508000003f, 0.00547000021f, 0.00547000021f, 0.00547000021f, 0.00577999977f, 0.00585999992f, 0.00554999989f, 0.00577999977f, 0.00608999981f, 0.00632999977f, 0.00625000009f, 0.00640999991f, 0.00625000009f, 0.00647999998f, 0.00680000009f, 0.00680000009f, 0.00671999995f, 0.00687000016f, 0.00726999994f, 0.0071899998f, 0.00749999983f, 0.00726999994f, 0.00766000012f, 0.00757999998f, 0.00734000001f, 0.00766000012f, 0.00773000019f, 0.00789000001f, 0.0080500003f, 0.00827999972f, 0.00836000033f, 0.00858999975f, 0.00858999975f, 0.00875000004f, 0.00891000032f, 0.00891000032f, 0.00922000036f, 0.00937999971f, 0.00961000007f, 0.00961000007f, 0.0099200001f, 0.0102300001f, 0.0103099998f, 0.0104700001f, 0.0108599998f, 0.0105499998f, 0.0109400004f, 0.0110900002f, 0.0113300001f, 0.0116400002f, 0.0115599995f, 0.0118000004f, 0.0119500002f, 0.0121900002f, 0.0123399999f, 0.0126599995f, 0.0128899999f, 0.0130500002f, 0.0132799996f, 0.0135899996f, 0.0135899996f, 0.0142200002f, 0.0142999999f, 0.0144499997f, 0.0143799996f, 0.0150800003f, 0.01523f, 0.01516f, 0.0153900003f, 0.0159399994f, 0.0161700007f, 0.0164800007f, 0.01664f, 0.0167200007f, 0.0169500001f, 0.01719f, 0.0176599994f, 0.0178900007f, 0.0180500001f, 0.0184400007f, 0.0184400007f, 0.0187500007f, 0.0190600008f, 0.0191399995f, 0.0196100008f, 0.0194499996f, 0.0199999996f, 0.0200800002f, 0.0204700008f, 0.0202300008f, 0.0207000002f, 0.0203900002f, 0.0210200008f, 0.0207800008f, 0.0214099996f, 0.0208599996f, 0.0212500002f, 0.0212500002f, 0.0217199996f, 0.0213300008f, 0.0219500009f, 0.0215600003f, 0.0222699996f, 0.0216400009f, 0.0225000009f, 0.0219500009f, 0.0225000009f, 0.0219500009f, 0.0225799996f, 0.0219500009f, 0.0226600002f, 0.0220299996f, 0.0229700003f, 0.0220299996f, 0.0228899997f, 0.0219500009f, 0.0232800003f, 0.0219500009f, 0.0229700003f, 0.0221100003f, 0.0225799996f, 0.0219500009f, 0.0230500009f, 0.0221100003f, 0.0228899997f, 0.0221100003f, 0.0230500009f, 0.0221100003f, 0.0231999997f, 0.0219500009f, 0.0229700003f, 0.0219500009f, 0.0228899997f, 0.0220299996f, 0.0231299996f, 0.0219500009f, 0.0228100009f},
  {0.0f, 0.00211f, 0.00203000009f, 0.00211f, 0.00218999991f, 0.00218999991f, 0.00227000006f, 0.00218999991f, 0.00227000006f, 0.00242000003f, 0.00233999989f, 0.00218999991f, 0.00242000003f, 0.00266f, 0.00249999994f, 0.00242000003f, 0.00242000003f, 0.00258000009f, 0.00266f, 0.00280999998f, 0.00280999998f, 0.00288999989f, 0.00280999998f, 0.00280999998f, 0.00304999994f, 0.00304999994f, 0.00304999994f, 0.00319999992f, 0.00319999992f, 0.00313000008f, 0.00319999992f, 0.00319999992f, 0.00335999997f, 0.00343999988f, 0.00352000003f, 0.00343999988f, 0.00367000001f, 0.00367000001f, 0.00383000006f, 0.00359000009f, 0.00398000004f, 0.00390999997f, 0.00390999997f, 0.00390999997f, 0.00406000018f, 0.00430000015f, 0.00430000015f, 0.00437999982f, 0.00430000015f, 0.00453000003f, 0.00453000003f, 0.00477f, 0.00477f, 0.00468999986f, 0.00484000007f, 0.00492000021f, 0.00492000021f, 0.00508000003f, 0.00499999989f, 0.00516000018f, 0.00516000018f, 0.00516000018f, 0.00522999978f, 0.00547000021f, 0.00547000021f, 0.00547000021f, 0.0057000001f, 0.00577999977f, 0.0057000001f, 0.00594000006f, 0.00585999992f, 0.00608999981f, 0.0060200002f, 0.00625000009f, 0.0060200002f, 0.00632999977f, 0.00656000013f, 0.00656000013f, 0.00647999998f, 0.00680000009f, 0.0066399998f, 0.00687999977f, 0.00694999984f, 0.00711000012f, 0.00749999983f, 0.00766000012f, 0.00757999998f, 0.00773000019f, 0.00789000001f, 0.00780999986f, 0.00789000001f, 0.00827999972f, 0.00820000004f, 0.00827999972f, 0.00867000036f, 0.00875000004f, 0.00898000039f, 0.00891000032f, 0.00906000007f, 0.00937999971f, 0.00930000003f, 0.00977000035f, 0.00977000035f, 0.00984000042f, 0.00999999978f, 0.0103900004f, 0.0105499998f, 0.0107000005f, 0.0107000005f, 0.0111699998f, 0.0109400004f, 0.0113300001f, 0.0113300001f, 0.0117199998f, 0.0116400002f, 0.0121900002f, 0.0122699998f, 0.0126599995f, 0.0125799999f, 0.0129699996f, 0.0130500002f, 0.0133600002f, 0.0133600002f, 0.0136700002f, 0.0139800003f, 0.0141399996f, 0.0145300003f, 0.0146899996f, 0.0145300003f, 0.0149999997f, 0.0153099997f, 0.0156999994f, 0.0156199997f, 0.0159399994f, 0.0162499994f, 0.01633f, 0.0164800007f, 0.01719f, 0.0171099994f, 0.0177299995f, 0.0177299995f, 0.0183600001f, 0.0181200001f, 0.0185899995f, 0.0187500007f, 0.0193000007f, 0.0189100001f, 0.0196100008f, 0.0196100008f, 0.0201600008f, 0.0199999996f, 0.0207000002f, 0.0200800002f, 0.0207800008f, 0.0207000002f, 0.0214799996f, 0.0206199996f, 0.0217199996f, 0.0208599996f, 0.0219500009f, 0.0212500002f, 0.0222699996f, 0.0213300008f, 0.0225000009f, 0.0216400009f, 0.0226600002f, 0.0218000002f, 0.0228899997f, 0.0221100003f, 0.0231299996f, 0.0222699996f, 0.0232800003f, 0.0221900009f, 0.0235200003f, 0.0225000009f, 0.0235900003f, 0.0227300003f, 0.0237499997f, 0.0225799996f, 0.0238300003f, 0.0227300003f, 0.0242199991f, 0.0227300003f, 0.0241400003f, 0.0228100009f, 0.0242199991f, 0.0228899997f, 0.0242199991f, 0.0229700003f, 0.0242199991f, 0.0229700003f, 0.0242999997f, 0.0227300003f, 0.0242199991f, 0.0229700003f, 0.0242199991f, 0.0229700003f, 0.0244500004f, 0.0229700003f, 0.0244500004f, 0.0231999997f, 0.0242199991f},
  {0.0f, 0.00141000003f, 0.00179999997f, 0.00164000003f, 0.00179999997f, 0.00171999994f, 0.00179999997f, 0.00171999994f, 0.00187000004f, 0.00194999995f, 0.00179999997f, 0.00187000004f, 0.00211f, 0.00218999991f, 0.00203000009f, 0.00233999989f, 0.00211f, 0.00218999991f, 0.00218999991f, 0.00242000003f, 0.00227000006f, 0.00249999994f, 0.00249999994f, 0.00249999994f, 0.00258000009f, 0.00266f, 0.00258000009f, 0.00280999998f, 0.00280999998f, 0.00280999998f, 0.00297000003f, 0.00304999994f, 0.00313000008f, 0.00304999994f, 0.00304999994f, 0.00297000003f, 0.00304999994f, 0.00313000008f, 0.00335999997f, 0.00335999997f, 0.00367000001f, 0.00359000009f, 0.00359000009f, 0.00359000009f, 0.00359000009f, 0.00390999997f, 0.00390999997f, 0.00383000006f, 0.00406000018f, 0.00413999986f, 0.00413999986f, 0.00430000015f, 0.00430000015f, 0.00437999982f, 0.00444999989f, 0.00444999989f, 0.00453000003f, 0.00461000018f, 0.00461000018f, 0.00453000003f, 0.00484000007f, 0.00499999989f, 0.00484000007f, 0.00499999989f, 0.00508000003f, 0.00508000003f, 0.00522999978f, 0.00547000021f, 0.00539000006f, 0.00563000003f, 0.00563000003f, 0.00561999995f, 0.00594000006f, 0.0060200002f, 0.00625000009f, 0.00616999995f, 0.00625000009f, 0.00656000013f, 0.0066399998f, 0.00671999995f, 0.0066399998f, 0.00687000016f, 0.00711000012f, 0.00726999994f, 0.00734000001f, 0.00766000012f, 0.00773000019f, 0.00796999969f, 0.00812000036f, 0.00812000036f, 0.00851999968f, 0.00858999975f, 0.00875000004f, 0.00882999972f, 0.00891000032f, 0.00930000003f, 0.00930000003f, 0.00977000035f, 0.00961000007f, 0.00984000042f, 0.00984000042f, 0.0101600001f, 0.0103900004f, 0.0106300004f, 0.0108599998f, 0.0110200001f, 0.0114099998f, 0.0112500004f, 0.0114799999f, 0.0118800001f, 0.0119500002f, 0.0122699998f, 0.0123399999f, 0.0128100002f, 0.0129699996f, 0.0131999999f, 0.0134399999f, 0.0135199996f, 0.0139800003f, 0.0139800003f, 0.0143799996f, 0.01461f, 0.0149999997f, 0.01523f, 0.0156199997f, 0.0156999994f, 0.0161700007f, 0.0164100006f, 0.0165599994f, 0.0167999994f, 0.0171099994f, 0.0175000001f, 0.0177299995f, 0.0182000007f, 0.0185899995f, 0.0186700001f, 0.0189800002f, 0.0192200001f, 0.0194499996f, 0.0195300002f, 0.0200800002f, 0.0199200008f, 0.0206199996f, 0.0207000002f, 0.0208599996f, 0.0209400002f, 0.0213300008f, 0.0211699996f, 0.0220299996f, 0.0218000002f, 0.0223399997f, 0.0222699996f, 0.0226600002f, 0.0225000009f, 0.0228899997f, 0.0225000009f, 0.0230500009f, 0.0227300003f, 0.0232800003f, 0.0231999997f, 0.0236699991f, 0.0233600009f, 0.0239100009f, 0.0237499997f, 0.0241400003f, 0.0239799991f, 0.0243800003f, 0.0238300003f, 0.0244500004f, 0.0239100009f, 0.0246900003f, 0.0242199991f, 0.0247699991f, 0.0240599997f, 0.0247699991f, 0.0241400003f, 0.0249199998f, 0.0239100009f, 0.0248399992f, 0.0239799991f, 0.0249199998f, 0.0241400003f, 0.0248399992f, 0.0239799991f, 0.0247699991f, 0.0241400003f, 0.0250000004f, 0.0239799991f, 0.0250000004f, 0.0240599997f, 0.0250000004f, 0.0239100009f, 0.0250799991f, 0.0241400003f, 0.0250799991f, 0.0239100009f, 0.0251599997f, 0.0239799991f, 0.0251599997f, 0.0238300003f, 0.0252299998f, 0.0240599997f},
  {0.0f, 0.00194999995f, 0.00194999995f, 0.00194999995f, 0.00194999995f, 0.00194999995f, 0.00211f, 0.00194999995f, 0.00187000004f, 0.00211f, 0.00211f, 0.00227000006f, 0.00218999991f, 0.00218999991f, 0.00233999989f, 0.00242000003f, 0.00227000006f, 0.00249999994f, 0.00266f, 0.00266f, 0.00266f, 0.00273000007f, 0.00273000007f, 0.00273000007f, 0.00304999994f, 0.00304999994f, 0.00313000008f, 0.00304999994f, 0.00304999994f, 0.00319999992f, 0.00328000006f, 0.00335999997f, 0.00352000003f, 0.00343999988f, 0.00352000003f, 0.00359000009f, 0.00367000001f, 0.00383000006f, 0.00374999992f, 0.00374999992f, 0.00398000004f, 0.00406000018f, 0.00406000018f, 0.00413999986f, 0.00406000018f, 0.00437999982f, 0.00413999986f, 0.00444999989f, 0.00461000018f, 0.00453000003f, 0.00430000015f, 0.00461000018f, 0.00477f, 0.00492000021f, 0.00477f, 0.00492000021f, 0.00484000007f, 0.00508000003f, 0.00530999992f, 0.00508000003f, 0.00516000018f, 0.00530999992f, 0.00547000021f, 0.00563000003f, 0.00563000003f, 0.00577999977f, 0.00577999977f, 0.0060200002f, 0.00616999995f, 0.00616999995f, 0.00640999991f, 0.00625000009f, 0.00656000013f, 0.00656000013f, 0.00680000009f, 0.00694999984f, 0.00694999984f, 0.00734000001f, 0.0071899998f, 0.00749999983f, 0.00766000012f, 0.00780999986f, 0.00780999986f, 0.0080500003f, 0.0080500003f, 0.00836000033f, 0.00851999968f, 0.00875000004f, 0.00891000032f, 0.00913999975f, 0.00937999971f, 0.00922000036f, 0.00953000039f, 0.00977000035f, 0.0099200001f, 0.00999999978f, 0.0102300001f, 0.0104700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
f, 0.0248399992f, 0.0254699998f, 0.0246099997f, 0.0254699998f},
  {0.0f, 0.00179999997f, 0.00179999997f, 0.00203000009f, 0.00203000009f, 0.00194999995f, 0.00203000009f, 0.00194999995f, 0.00211f, 0.00227000006f, 0.00218999991f, 0.00218999991f, 0.00242000003f, 0.00242000003f, 0.00233999989f, 0.00242000003f, 0.00249999994f, 0.00242000003f, 0.00266f, 0.00266f, 0.00258000009f, 0.00258000009f, 0.00288999989f, 0.00280999998f, 0.00288999989f, 0.00288999989f, 0.00297000003f, 0.00297000003f, 0.00313000008f, 0.00313000008f, 0.00328000006f, 0.00319999992f, 0.00343999988f, 0.00319999992f, 0.00352000003f, 0.00359000009f, 0.00367000001f, 0.00359000009f, 0.00374999992f, 0.00374999992f, 0.00390999997f, 0.00390999997f, 0.00413999986f, 0.00430000015f, 0.00413999986f, 0.00406000018f, 0.00422f, 0.00437999982f, 0.00437999982f, 0.00444999989f, 0.00461000018f, 0.00437999982f, 0.00468999986f, 0.00484000007f, 0.00477f, 0.00477f, 0.00492000021f, 0.00522999978f, 0.00516000018f, 0.00516000018f, 0.00539000006f, 0.00539000006f, 0.00530999992f, 0.00539000006f, 0.0057000001f, 0.00577999977f, 0.00585999992f, 0.00616999995f, 0.00625000009f, 0.00616999995f, 0.00632999977f, 0.00656000013f, 0.0066399998f, 0.00656000013f, 0.00694999984f, 0.00694999984f, 0.00726999994f, 0.0071899998f, 0.00742000015f, 0.00749999983f, 0.00757999998f, 0.0080500003f, 0.0080500003f, 0.00827999972f, 0.00820000004f, 0.00858999975f, 0.00867000036f, 0.00867000036f, 0.00898000039f, 0.00891000032f, 0.00937999971f, 0.00953000039f, 0.00977000035f, 0.00984000042f, 0.0100800004f, 0.0100800004f, 0.0102300001f,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
  {0.420289189f, 0.684889317f, 0.287851572f, 2.0f, 0.428555697f, 0.895995259f, 0.854810417f, 0.793080688f, 0.687434375f, 0.515506446f, 0.189632267f, 0.166391566f, 0.144049436f, 0.119518586f},
};
static const uint8_t UJI_KEPUTUSAN[N_UJI] = {2, 2, 0, 0, 0, 2, 2, 2, 2, 2, 0, 2};
