dauzan/ShadeShift/firmware/shadeshift_firmware/pemilih_bobot.h

// Bobot model pemilih susunan SHADESHIFT (regresi logistik, dilatih simulasi, sapuan 4S). Dibuat otomatis oleh latih_ekspor.py.
// Urutan fitur: Vmp_Voc, Imp_Isc, FF, n_puncak, P2_Pmax, I@0.1Voc, I@0.2Voc, I@0.3Voc, I@0.4Voc, I@0.5Voc, I@0.6Voc, I@0.7Voc, I@0.8Voc, I@0.9Voc
// Urutan kelas: 0 = 4S, 1 = 2S2P, 2 = TCT
#pragma once
#define PEMILIH_N_FITUR 14
#define PEMILIH_N_KELAS 3
static const float PEMILIH_RERATA[PEMILIH_N_FITUR] = {0.657826841f, 0.729184151f, 0.470804453f, 1.89383328f, 0.485196054f, 0.972396374f, 0.917078793f, 0.864031553f, 0.828696847f, 0.703371584f, 0.666592419f, 0.548830211f, 0.374598801f, 0.33558771f};
static const float PEMILIH_SKALA[PEMILIH_N_FITUR] = {0.164266378f, 0.141658172f, 0.126492724f, 0.765764534f, 0.385251224f, 0.0258890614f, 0.061759796f, 0.129995435f, 0.132735461f, 0.214290708f, 0.222171813f, 0.192789212f, 0.255603909f, 0.224543095f};
static const float PEMILIH_BOBOT[PEMILIH_N_KELAS][PEMILIH_N_FITUR] = {
  {0.114765607f, 0.127242118f, 1.3566612f, 0.227100685f, -0.137828082f, 0.04601321f, -0.161031649f, 0.072950013f, -0.384112269f, -0.268058151f, 0.926591516f, -0.293637067f, 0.614711761f, -2.39321971f},
  {-0.0142135443f, -0.0361542031f, -1.43260396f, -0.1441257f, -0.0379540995f, -0.0244321171f, 0.0914740786f, 0.1419359f, 0.104272455f, 0.566443861f, -1.56648374f, 0.714822888f, 0.25067547f, 1.36687899f},
  {-0.100552067f, -0.091087915f, 0.0759427696f, -0.0829749852f, 0.175782189f, -0.0215810928f, 0.0695575774f, -0.214885905f, 0.279839814f, -0.29838568f, 0.63989222f, -0.421185821f, -0.865387201f, 1.02634084f},
};
static const float PEMILIH_BIAS[PEMILIH_N_KELAS] = {0.960911572f, -2.13339901f, 1.1724875f};
