dauzan/ShadeShift/(commit log)

2026-10-17 Stage 0: restore runnable baseline, pin deps, offline Streamlit config, tests
    - Extracted SHADESHIFT_untuk_Dauzan.zip into docs/before/ (byte-identical snapshot)
    and restored the working tree from it with tools/restore_from_before.py:
    SHADESHIFT_ML/ (minus six large research CSVs), firmware/, rangkaian/, foto/,
    UNTUK_DAUZAN.md. The existing Streamlit dashboard now runs in place unchanged.
    - Phase 1/2 documents: ANALYSIS.md, CONTRACT.md, PLAN.md.
    - Pinned requirements (streamlit 1.66.0; the code needs >= 1.51) and dev deps.
    - .streamlit/config.toml: no usage telemetry, no Deploy button, headless.
    - shadeshift/config.py + .env.example: settings from flags > env > .env > defaults.
    - uji_p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
    [A_selisih_domain.csv, B_pemilihan_rinci.csv, B_pemilihan_ringkas.csv, C_diagnosis_rinci.csv, C_diagnosis_ringkas.csv, V1_2S2P_u1.csv, V1_2S2P_u2.csv, V1_2S2P_u3.csv]
2026-10-17 Stage 1: local FastAPI+SQLite server with ingestion, commands, uploads, WebSocket stream
    - shadeshift/server: schema v1 (WAL, migrations), pydantic request models,
    ingestion (sweeps, decisions, events, metrics, evaluations, log) with
    idempotent UUIDs, heartbeat/runs, command queue with gateway long-poll and
    expiry, reads (snapshot, sweeps, conditions, events.csv audit trail, metrics
    summary, runs, uploads, scenarios, model), CSV uploads, read-only lab import,
    digital-twin expectation/calibration and alerts, WebSocket /stream, optional
    write token, offline /docs page (no CDN).
    - shadeshift/protocol.py: firmware block parser (raw rows, header, v3 lines,
    completeness) with derived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
    [V1c_TCT_u1_plain.csv, V1c_TCT_u1_plain_mA.csv, V3_opak_4S_u1.csv, bad_non_numeric.csv, bad_too_few_points.csv]
2026-10-17 Stage 2: edge gateway (serial/emulator) with ONNX Runtime selector, outbox and safe Stop
    - shadeshift/gateway: owns the ESP32 serial port (auto-detected by USB id) or the
    emulated device; parses sweeps; measures switch/sweep/decision times; runs the
    selector at the edge; executes commands (raw allowlist, auto_select, auto mode,
    cycle, stop, demo_condition); forwards everything to the server through a
    SQLite outbox that survives server downtime; heartbeat and reconnect.
    - Edge AI: models/pemilih.onnx generated from pemilih_bobot.h
    (python -m shadeshift.edge.export_onnx); ONNX Runtime on CPU only, telemetry
    disabled; numpy fallback with a recorded reason; same decisions as the C co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
2026-10-17 Stage 3: dashboard as API client (live, replay, CSV upload, events, status) and one-command start
    - dasbor/app.py rebuilt with st.navigation; pages in dasbor/halaman/: Langsung
    (device picker, commands, auto-select, auto mode, live metrics with "decided by"
    and decision time, I-V/P-V with twin curve, history, events, serial log; 1 s
    refresh), Putar ulang (lab sets + 30-set summary, uploads, recorded runs),
    Unggah CSV (accepted/rejected per file with reasons, AI decision for 4S),
    Peristiwa (audit trail + CSV), Status (server, gateway, edge runtime, model
    claims, source labels). DEMO labels on every demo chart and table.
    - The dashboard no longer opens serial ports; refresh and sec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
2026-10-18 Stage 4: demo mode with shading scenarios on the emulated ESP32
    - shadeshift/gateway/demo.py: scenario loader (validates conditions, repeats,
    timing) and player. It changes the emulated lab condition along a timeline and
    runs the normal auto mode, so the edge AI reacts as it would on hardware;
    speed scales timeline, emulated delays and auto-mode timing; loops; progress
    as events and in the heartbeat; any stop ends it; refused on a real ESP32.
    - scenarios/: default (V1c -> V3_paranet65 -> V4_paranet65 -> V1c, selector
    right at every step), kilat (3x for rehearsals), v6_kelemahan (known weak case).
    - Dashboard Live page: scenario picker, speed, start/stop, progress banner.
    - run.py d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
2026-10-18 Stage 6: firmware v3 with the selector running on the ESP32 (TinyML), gateway support
    - firmware/shadeshift_firmware_v3: v2 plus pemilih.h on the board after every 4S
    sweep ("# pemilih=..., skor=..., t_us=..."), computed on exactly the printed
    numbers; PILIH (on-board auto-select); INFO with the weights fingerprint
    (same SHA-256 as the laptop model id); "# meta t_ms, seq"; safety fixes:
    OFF/STOP/BATAL honoured inside SIKLUS and PILIH, failed sweep ends SIKLUS,
    RELAI/UJIRELAI/DAC only in BENCH 1 mode. The safe switching sequence and
    the sweep format are unchanged. TAHAN deliberately not implemented (heat).
    - firmware/CARA_PAKAI_v3.md: what changed and a board checklist for the tea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
    [Wire.h, arduino_stub.h, pemilih.h, pemilih_bobot.h, pemilih_cli.c, pemilih_sidik.h, sim_main.cpp]
2026-10-18 Stage 8: setup and start scripts, README, START_HERE, CHANGELOG
    - setup.bat: creates .venv, installs the pinned packages (pip cache kept in the
    project on drive D), runs run.py check. Verified on a brand-new environment:
    all checks OK and all 278 tests pass there.
    - start_demo.bat / start_live.bat: double-click starters (options passed on).
    - README.md (overview, quick start, commands, folders, docs index),
    START_HERE.md (fresh-laptop setup, complete / board-only / not-built table,
    Demo Day runbook with fallback, claims to use and avoid, assumptions, what
    the team must provide), CHANGELOG.md.
    - PLAN.md status note, ANALYSIS.md review corrections, progress.md log entry.
    - .gitattrib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
2026-10-25 Add the project
    [A_selisih_domain.csv, B_pemilihan_rinci.csv, B_pemilihan_ringkas.csv, C_diagnosis_rinci.csv, C_diagnosis_ringkas.csv, V1_2S2P_u1.csv, V1_2S2P_u2.csv, V1_2S2P_u3.csv]
